ust-modules/USTTHUNDERMILLPCB03/README.md

# THUNDERMILL electrodes PCB

The PCB is part of [Electric field mill](https://github.com/UniversalScientificTechnologies/THUNDERMILL01).

<p float="left">
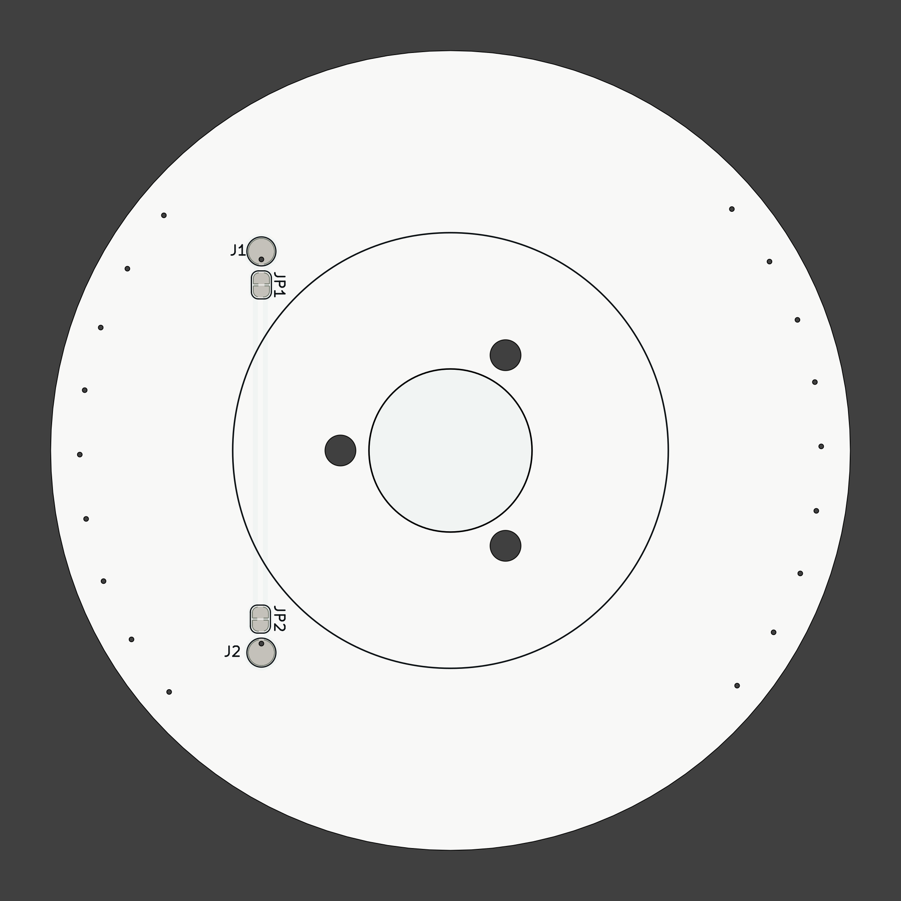
[picture p1: doc/gen/img/USTTHUNDERMILLPCB03-bottom.png]
  
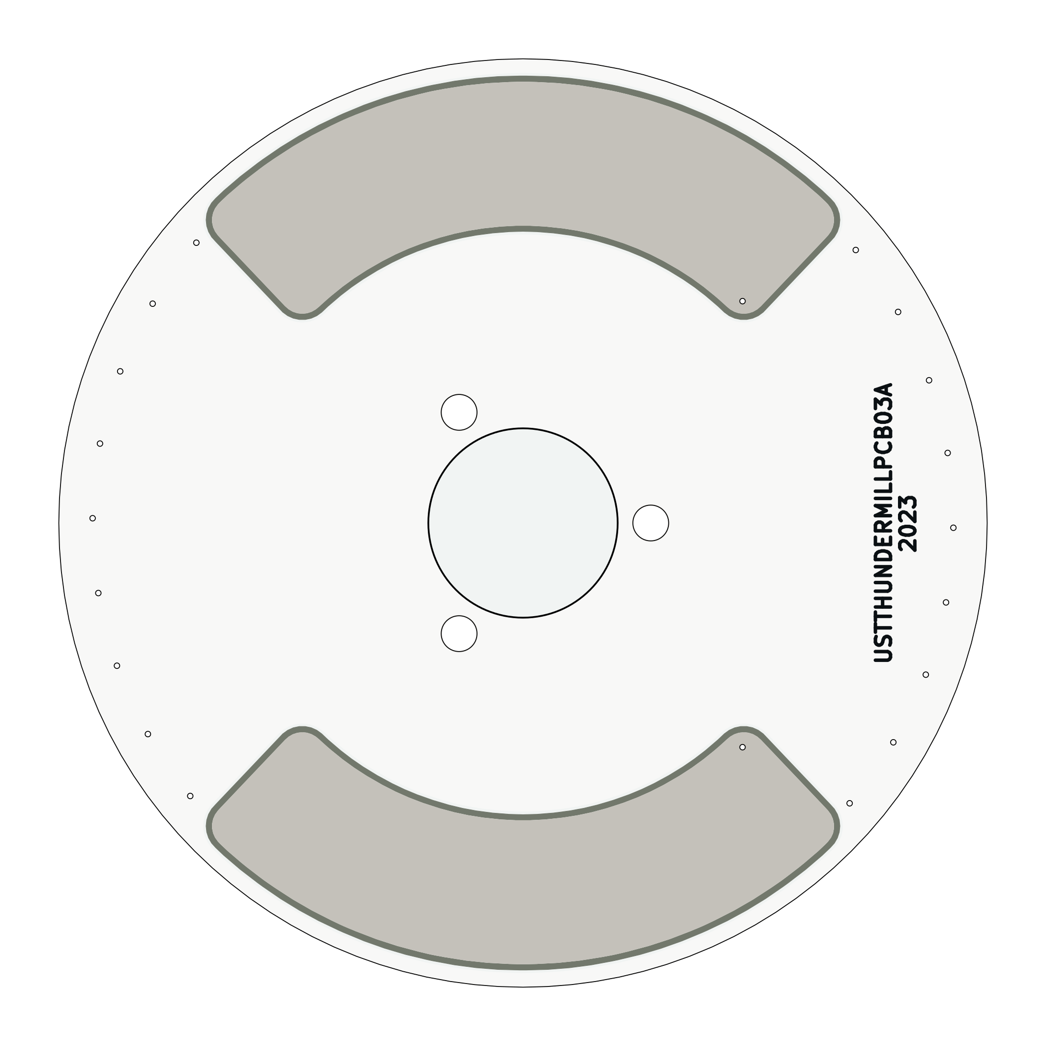
[picture p2: doc/gen/img/USTTHUNDERMILLPCB03-top.png]
   
</p>
