ust-modules/USTTHUNDERMILLPCB03/doc/gen/README.md

# PCB

Board size: 80.0x80.0 mm (3.15x3.15 inches)

- This is the size of the rectangle that contains the board
- Thickness: 1.6 mm (63 mils)
- Material: FR4
- Finish: Immersion gold
- Layers: 2
- Copper thickness: 35 µm

Solder mask: TOP / BOTTOM

- Color: White

Silk screen: TOP / BOTTOM

- Color: Black

Special features:

- Castellated pads
- Edge plating

Stackup:

| Name | Type | Color | Thickness | Material | Epsilon_r | Loss tangent |
|---|---|---|---|---|---|---|
| F.SilkS | Top Silk Screen | Black | | | | |
| F.Paste | Top Solder Paste | | | | | |
| F.Mask | Top Solder Mask | White | 10 | | | |
| F.Cu | copper | | 35 | | | |
| dielectric 1 | core | FR4 natural | 1510 | FR4 | 4.5 | 0.020 |
| B.Cu | copper | | 35 | | | |
| B.Mask | Bottom Solder Mask | White | 10 | | | |
| B.Paste | Bottom Solder Paste  | | | | | |
| B.SilkS | Bottom Silk Screen | Black | | | | |

# Important sizes

Clearance: 0.2 mm (8 mils)

Track width: 0.5 mm (20 mils)

- By design rules: 0.2 mm (8 mils)

Drill: 0.5 mm (20 mils)

- Vias: 0.5 mm (20 mils) [Design: 0.4 mm (16 mils)]
- Pads: 3.1 mm (122 mils)
- The above values are real drill sizes, they add 0.1 mm (4 mils) to plated holes (PTH)

Via: 0.8/0.4 mm (31/16 mils)

- By design rules: 0.4/0.3 mm (16/12 mils)
- Micro via: yes [0.2/0.1 mm (8/4 mils)]
- Buried/blind via: yes
- Total: 20 (thru: 20 buried/blind: 0 micro: 0)

Outer Annular Ring: 0.15 mm (6 mils)

- By design rules: N/A mm (N/A mils)

Eurocircuits class: 4B
- Using min drill 0.5 mm for an OAR of 0.15 mm

# General stats

Components count: (SMD/THT)

- Top: 0/3 (THT)
- Bottom: 0/0 (NONE)

Defined tracks:

- 0.2 mm (8 mils)
- 0.25 mm (10 mils)
- 0.3 mm (12 mils)
- 0.5 mm (20 mils)

Used tracks:

- 0.5 mm (20 mils) (6) defined: yes

Defined vias:

Used vias:

- 0.8/0.4 mm (31/16 mils) (Count: 20, Aspect: 2.0 A) defined: no

Holes (excluding vias):

- 3.0 mm (118 mils) (3)

Oval holes:

Drill tools (including vias and computing adjusts and rounding):

- 0.5 mm (20 mils) (20)
- 3.1 mm (122 mils) (3)
