ust-modules/USTTHUNDERMILLPCB03/doc/img/USTTHUNDERMILLPCB01A_bot.png

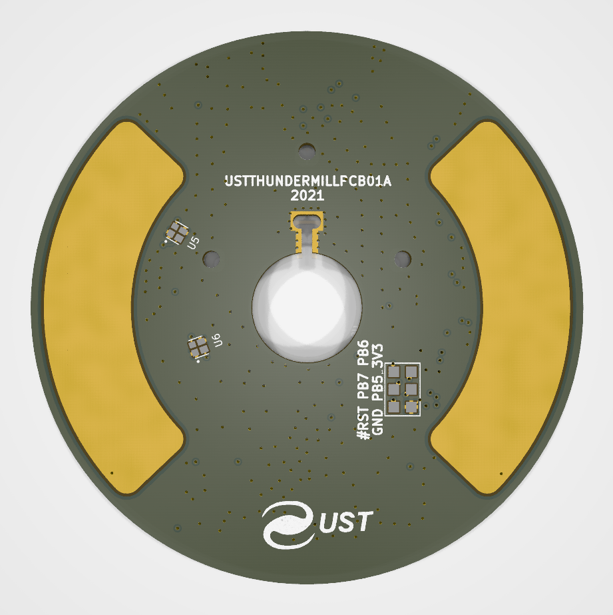
doc/img/USTTHUNDERMILLPCB01A_bot.png
