ust-modules/USTTHUNDERMILLPCB03/doc/img/USTTHUNDERMILLPCB01A_top.png

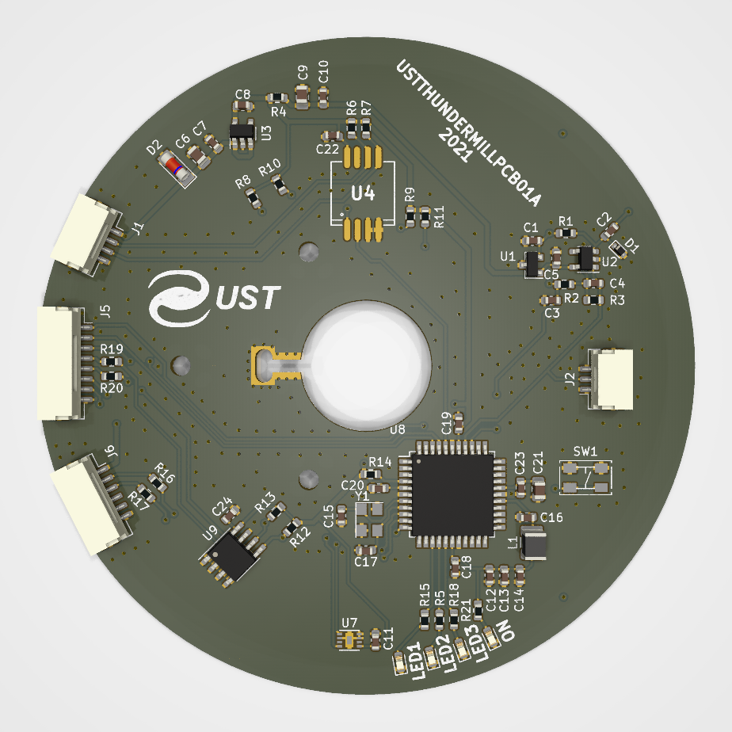
doc/img/USTTHUNDERMILLPCB01A_top.png
