ust-modules/USTTHUNDERMILLPCB03/CAD/stl/programming_holder.stl

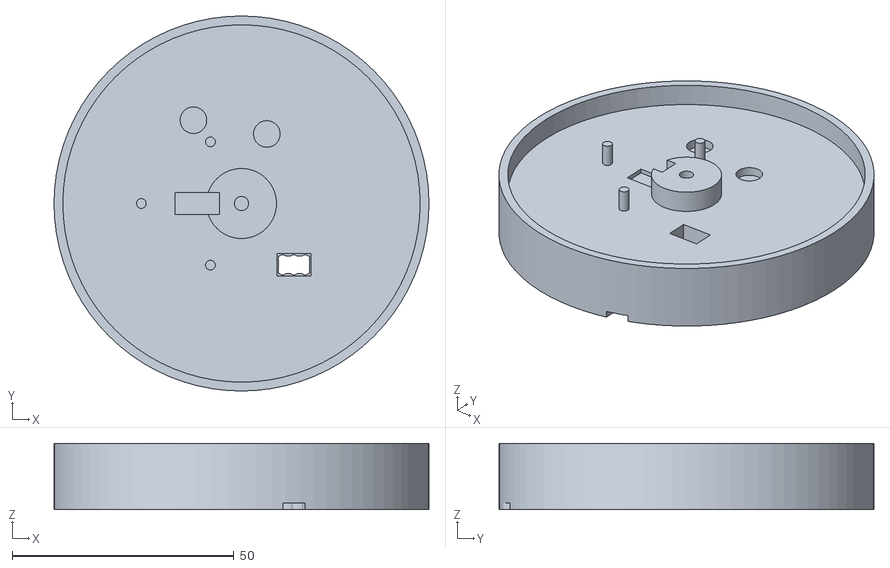
[picture p5: CAD file, 2021-08-31]
CAD/stl/programming_holder.stl
84.6 x 84.6 x 15.0
