ust-modules/USTTHUNDERMILLPCB03/doc/3d/USTTHUNDERMILLPCB03.stl

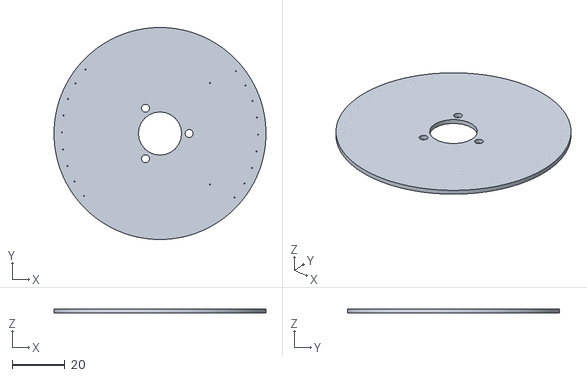
[picture p6: CAD file, 2025-04-03]
doc/3d/USTTHUNDERMILLPCB03.stl
80.0 x 80.0 x 1.66
