ust-modules/USTTHUNDERMILLPCB03/doc/gen/dxf/USTTHUNDERMILLPCB03-F_Fab.dxf

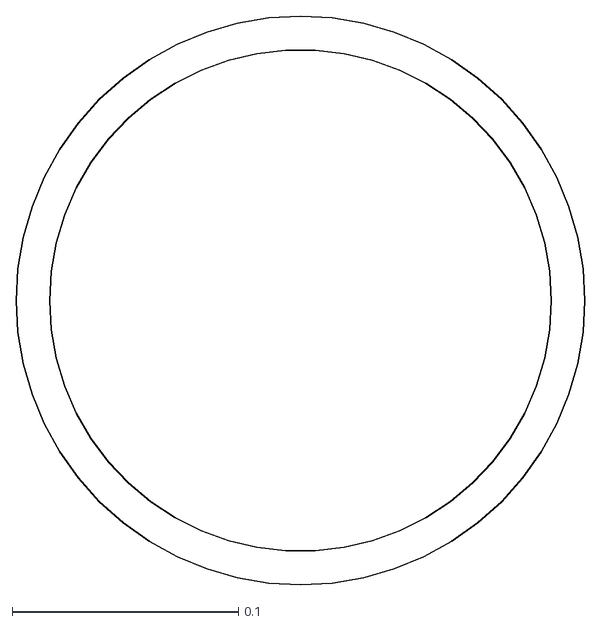
[picture p7: CAD file, 2025-04-03]
doc/gen/dxf/USTTHUNDERMILLPCB03-F_Fab.dxf
0.251 x 0.251
