ust-modules/USTTHUNDERMILLPCB03/doc/gen/USTTHUNDERMILLPCB03.step

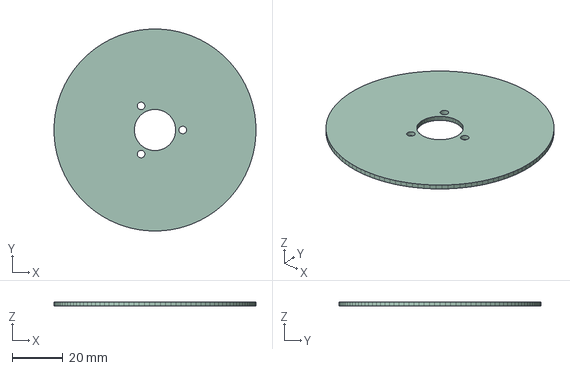
[picture p8: CAD file, 2025-04-03]
doc/gen/USTTHUNDERMILLPCB03.step
80.0 x 80.0 x 1.58 mm
