ust-modules/USTTHUNDERMILLPCB03/doc/gen/dxf/USTTHUNDERMILLPCB03-Edge_Cuts.dxf

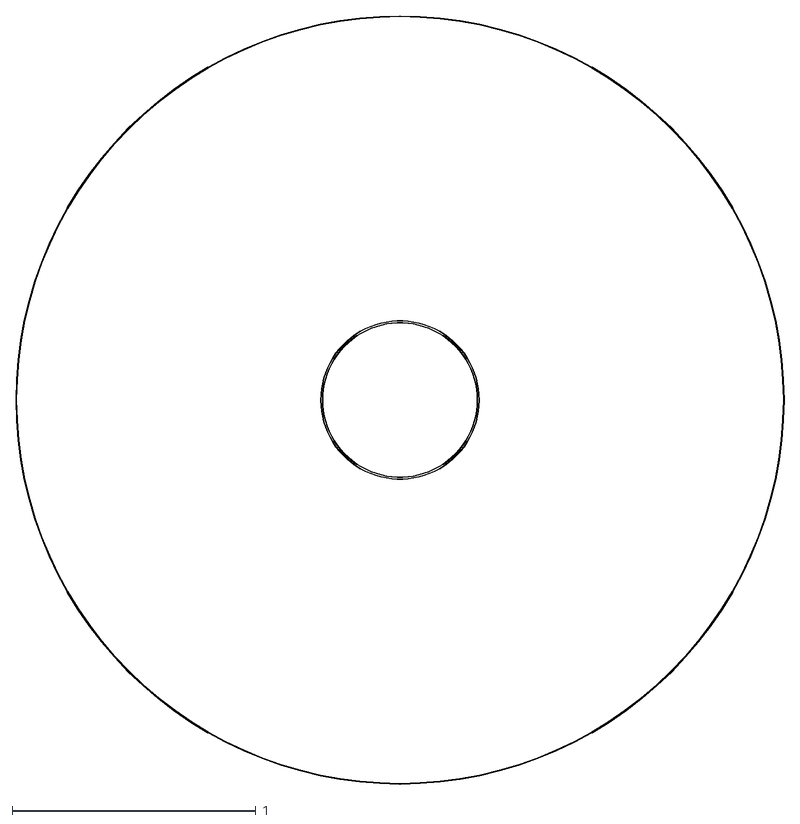
[picture p9: CAD file, 2025-04-03]
doc/gen/dxf/USTTHUNDERMILLPCB03-Edge_Cuts.dxf
3.15 x 3.15
