ust-modules/USTTHUNDERMILLPCB03/doc/gen/dxf/USTTHUNDERMILLPCB03-B_Fab.dxf

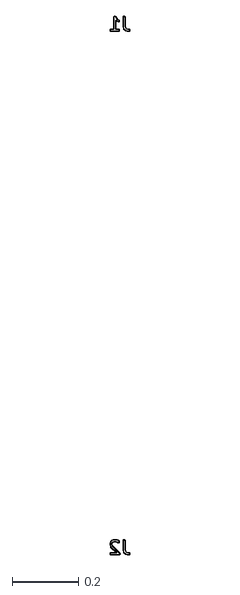
[picture p10: CAD file, 2025-04-03]
doc/gen/dxf/USTTHUNDERMILLPCB03-B_Fab.dxf
0.0602 x 1.62
