ust-modules/USTTHUNDERMILLPCB03/doc/gen/dxf/USTTHUNDERMILLPCB03-B_Cu.dxf

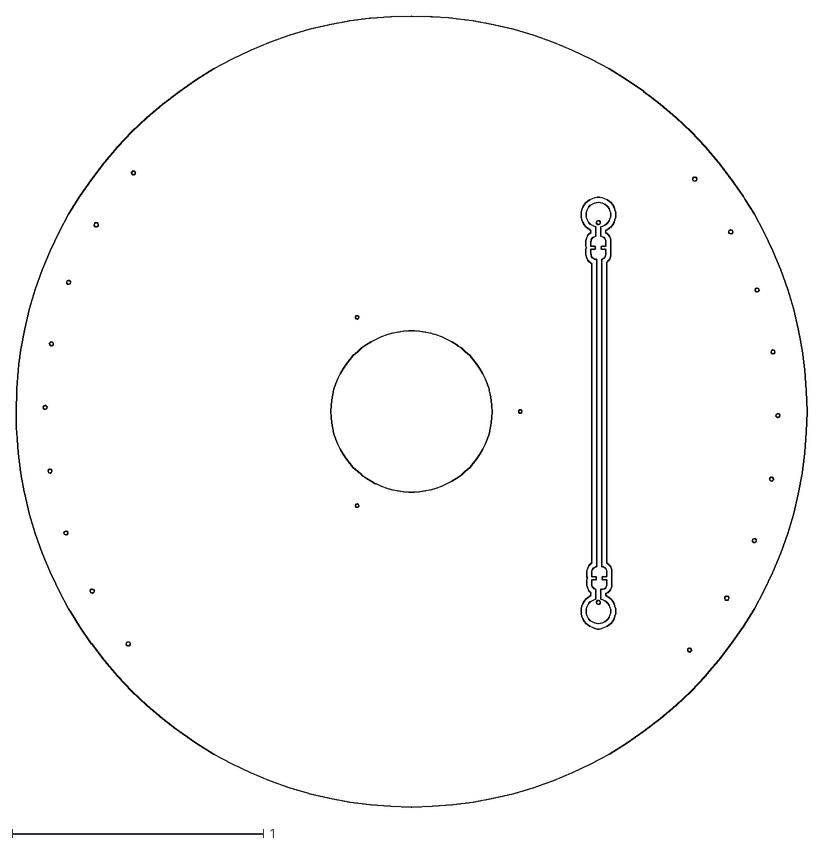
[picture p12: CAD file, 2025-04-03]
doc/gen/dxf/USTTHUNDERMILLPCB03-B_Cu.dxf
3.15 x 3.15
