ust-modules/USTTHUNDERMILLPCB03/doc/gen/dxf/USTTHUNDERMILLPCB03-User_Comments.dxf

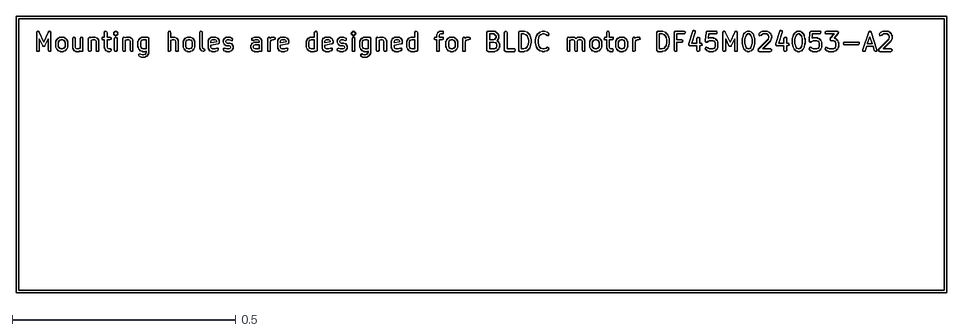
[picture p13: CAD file, 2025-04-03]
doc/gen/dxf/USTTHUNDERMILLPCB03-User_Comments.dxf
2.08 x 0.62
