ust-modules/USTTHUNDERMILLPCB03/doc/gen/dxf/USTTHUNDERMILLPCB03-B_Courtyard.dxf

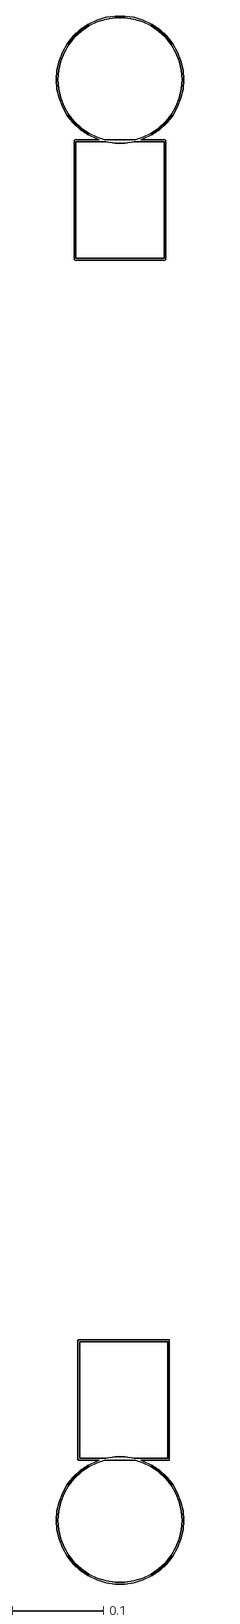
[picture p14: CAD file, 2025-04-03]
doc/gen/dxf/USTTHUNDERMILLPCB03-B_Courtyard.dxf
0.14 x 1.72
