ust-modules/USTTHUNDERMILLPCB03/(list of files, cad)

Other CAD files:
doc/gen/dxf/USTTHUNDERMILLPCB03-User_Drawings.dxf
doc/gen/dxf/USTTHUNDERMILLPCB03-B_Adhesive.dxf
doc/gen/dxf/USTTHUNDERMILLPCB03-F_Adhesive.dxf
doc/gen/dxf/USTTHUNDERMILLPCB03-F_Courtyard.dxf
doc/gen/dxf/USTTHUNDERMILLPCB03-Margin.dxf
doc/gen/dxf/USTTHUNDERMILLPCB03-B_Mask.dxf
doc/gen/dxf/USTTHUNDERMILLPCB03-B_Paste.dxf
doc/gen/dxf/USTTHUNDERMILLPCB03-B_Silkscreen.dxf
doc/gen/dxf/USTTHUNDERMILLPCB03-F_Mask.dxf
doc/gen/dxf/USTTHUNDERMILLPCB03-F_Paste.dxf
doc/gen/dxf/USTTHUNDERMILLPCB03-F_Silkscreen.dxf
