ust-modules/USTTHUNDERMILLPCB03/doc/gen/USTTHUNDERMILLPCB03-schematic.pdf

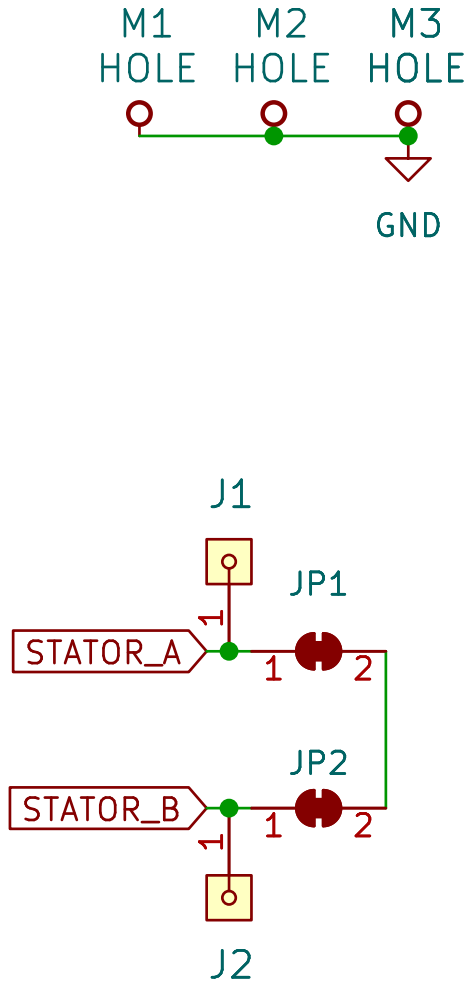
[picture p15: page 1]
