ust-modules/USTTHUNDERMILLPCB03/hw/cam_profi/docs/USTTHUNDERMILLPCB03A-B_Fab+Edge_Cuts.pdf

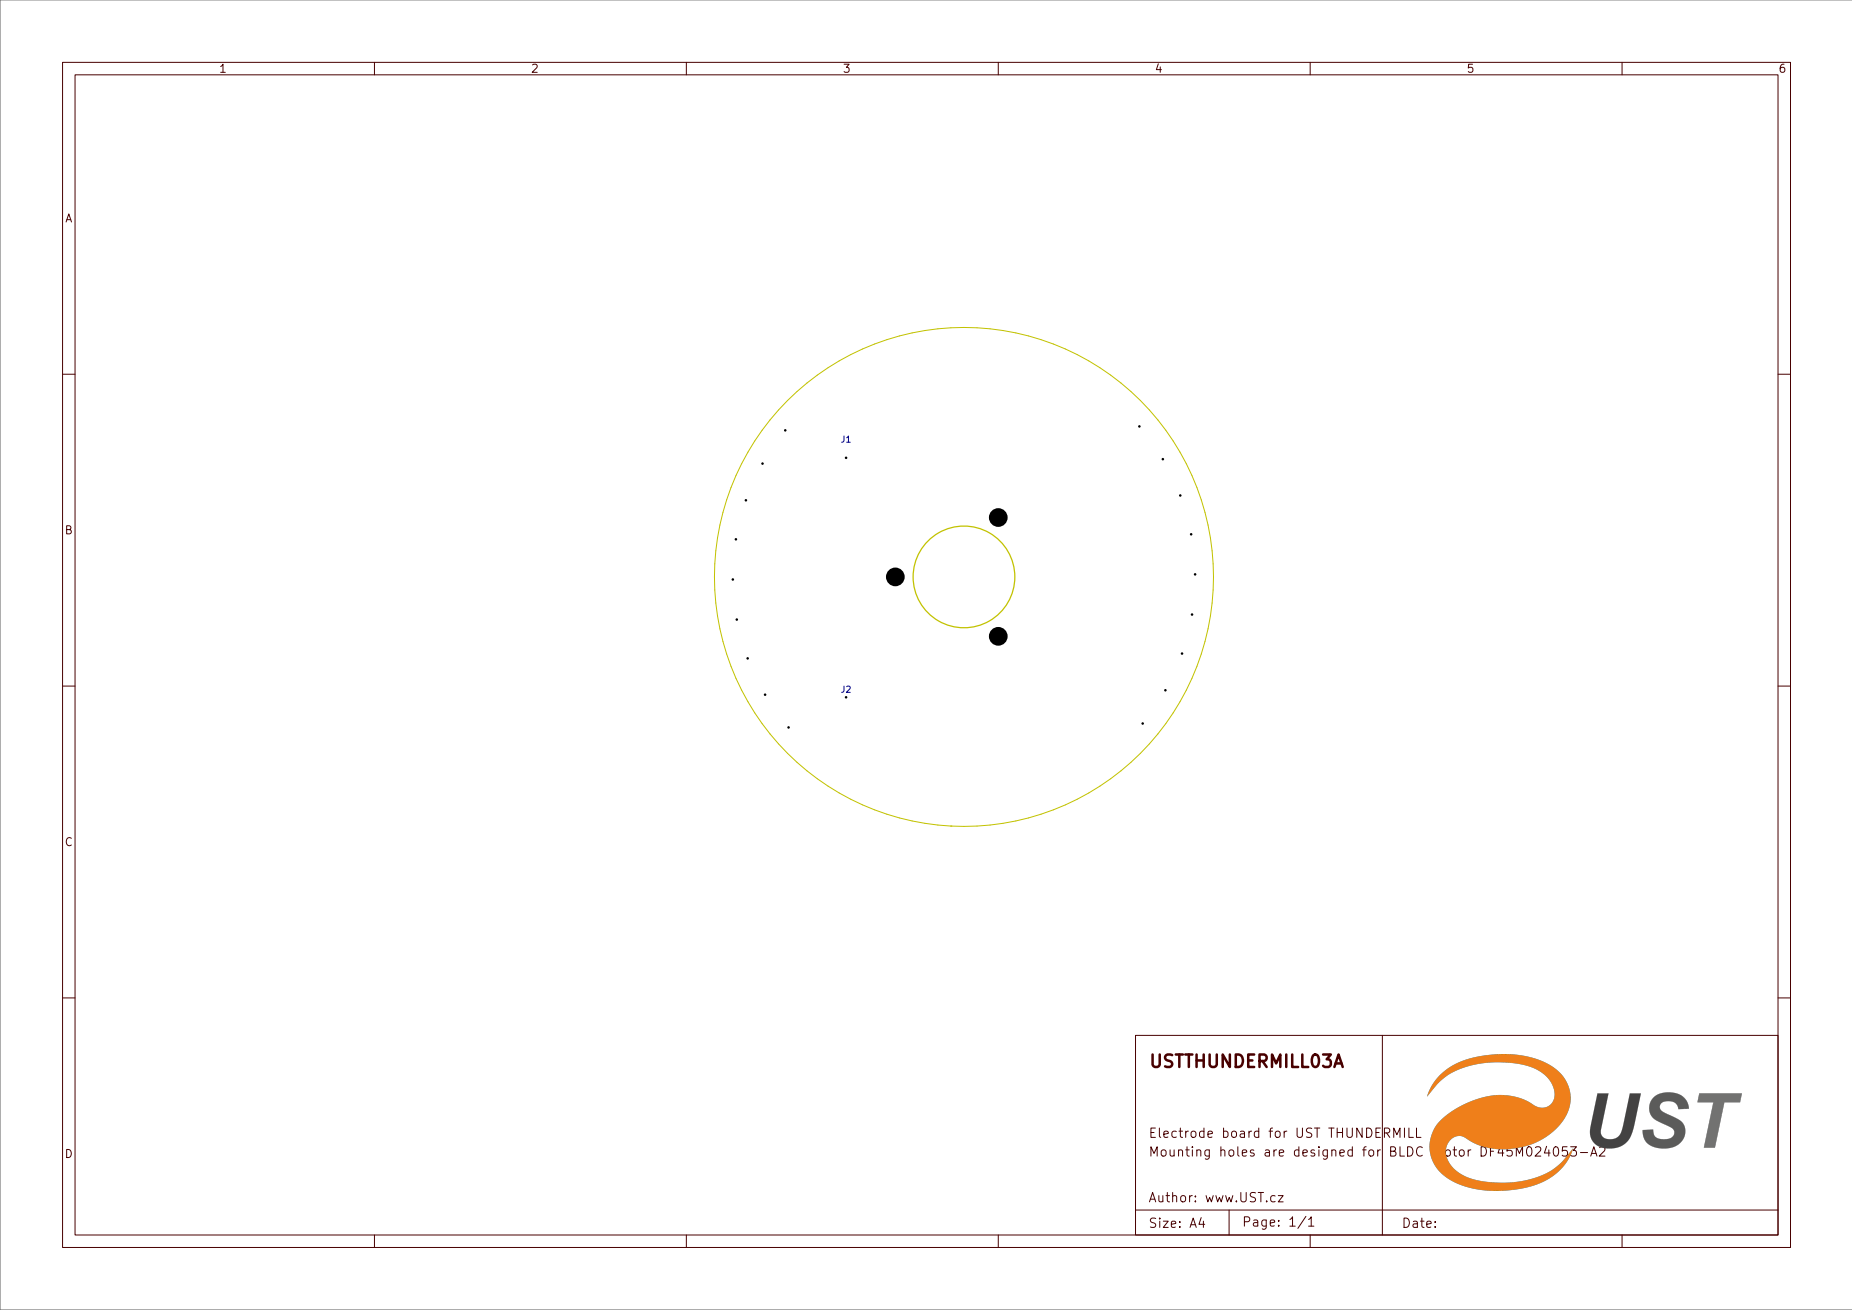
[picture p16: page 1]
