ust-modules/USTTHUNDERMILLPCB03/hw/cam_profi/docs/USTTHUNDERMILLPCB03A-F_Fab+Edge_Cuts.pdf

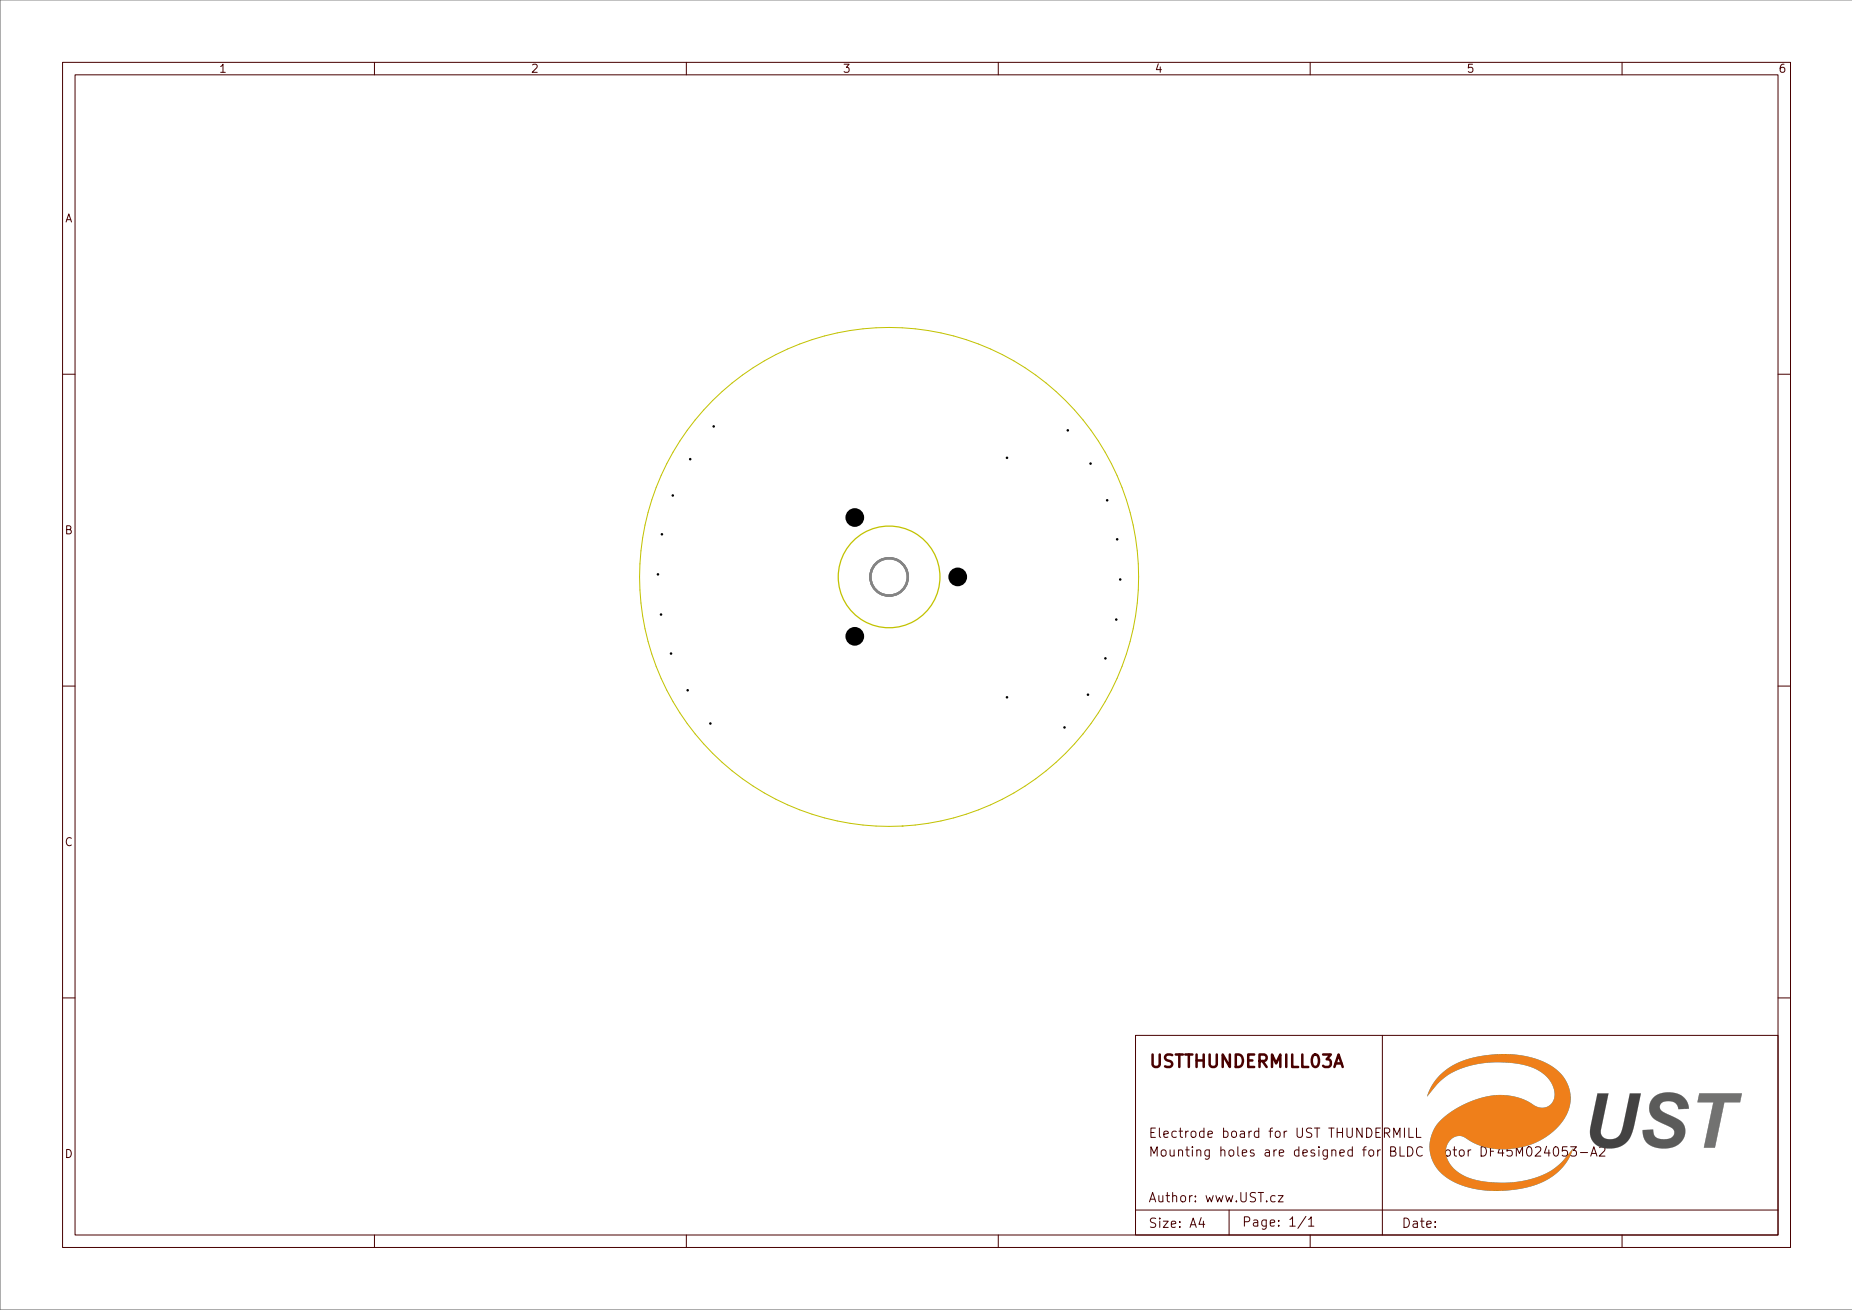
[picture p17: page 1]
