ust-modules/USTTHUNDERMILLPCB03/(commit log)

2021-07-23 Edit schema
    [USTTHUNDERMILLPCB01A.kicad_pcb, USTTHUNDERMILLPCB01A.kicad_sch, tachometer.kicad_sch]
2021-08-18 Edit PCB
    [USTTHUNDERMILLPCB01A.kicad_pcb]
2021-08-18 Import Openscad exports
    [USTTHUNDERMILLPCB01A.kicad_pcb]
2021-08-18 uprava layoutu
    [USTTHUNDERMILLPCB01A.kicad_pcb]
2021-08-20 uprava layoutu, aktualizace elektrod
    [USTTHUNDERMILLPCB01A.kicad_pcb, USTTHUNDERMILLPCB01A.kicad_sch, tachometer.kicad_sch]
2021-08-21 Edit vylití CU
    [USTTHUNDERMILLPCB01A.kicad_pcb]
2021-08-21 uprava pcb
    [USTTHUNDERMILLPCB01A.kicad_pcb]
2021-08-22 edit pcb
    [USTTHUNDERMILLPCB01A.kicad_pcb]
2021-08-23 Edit shema and PCB
    [CPU.kicad_sch, USTTHUNDERMILLPCB01A.kicad_pcb, USTTHUNDERMILLPCB01A.kicad_sch, tachometer.kicad_sch]
2021-08-23 uprava PCB - zmena mlynku - oddeleni propojovaci cesticky.
    [USTTHUNDERMILLPCB01A.kicad_pcb]
2021-08-23 otoceni cesticky
    [USTTHUNDERMILLPCB01A.kicad_pcb]
2021-08-24 Pridani keep-out okolo elektrod
    [USTTHUNDERMILLPCB01A.kicad_pcb]
2021-08-24 zmena okraju
    [USTTHUNDERMILLPCB01A.kicad_pcb]
2021-08-24 Clean layout of some tracks by using free-angle rounting.
    [USTTHUNDERMILLPCB01A.kicad_pcb]
2021-08-24 Logo moved to the rotor window.
    [USTTHUNDERMILLPCB01A.kicad_pcb]
2021-08-24 Move connectors.
    [USTTHUNDERMILLPCB01A.kicad_pcb]
2021-08-24 Silkscreen cleanup - DRC errors elimination.
    [CPU.kicad_sch, USTTHUNDERMILLPCB01A.kicad_pcb, USTTHUNDERMILLPCB01A.kicad_sch, tachometer.kicad_sch]
2021-08-24 Eliminate some DRC errors.
    [USTTHUNDERMILLPCB01A.kicad_pcb]
2021-08-24 Cleanup silkscreen graphics. Turn on labels.
    [USTTHUNDERMILLPCB01A.kicad_pcb]
2021-08-25 Change colors in PCB board stackup.
    [USTTHUNDERMILLPCB01A.kicad_pcb]
2021-08-27 Edit BOM
    [USTTHUNDERMILLPCB01A.csv, USTTHUNDERMILLPCB01A.kicad_sch]
2021-08-27 add CAD programming tool
    [programming_holder.scad, programming_holder.stl]
2021-09-01 nefunkcni ADC
2021-09-05 RPM sensor output was added to mavlink packet
2021-12-24 Add UST title block and assets submodule.
    [CPU.kicad_sch, USTTHUNDERMILLPCB01A.kicad_sch, tachometer.kicad_sch]
2022-04-17 clean repo, restructualize git repository, add actions, ..
    [CPU.kicad_sch, USTTHUNDERMILLPCB01.csv, USTTHUNDERMILLPCB01.kicad_pcb, USTTHUNDERMILLPCB01.kicad_sch, USTTHUNDERMILLPCB01A.kicad_pcb, tachometer.kicad_sch]
2022-04-17 Update actions products
    [USTTHUNDERMILLPCB01-B_Adhesive.dxf, USTTHUNDERMILLPCB01-B_Courtyard.dxf, USTTHUNDERMILLPCB01-B_Cu.dxf, USTTHUNDERMILLPCB01-B_Fab.dxf, USTTHUNDERMILLPCB01-B_Mask.dxf, USTTHUNDERMILLPCB01-B_Paste.dxf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]
2022-04-17 resave in 6.0.4
    [USTTHUNDERMILLPCB01.kicad_pcb, USTTHUNDERMILLPCB01.kicad_sch]
2023-06-08 solve #3 in schematics, not in layout
    [CPU.kicad_sch, USTTHUNDERMILLPCB01.kicad_sch]
2023-06-09 Schema: #7 add schmidt, #6, #8 dvojice UART konetkoru + i2c, #3 pridan kondenzator a propojeni na RST
    [CPU.kicad_sch, USTTHUNDERMILLPCB01.kicad_sch, tachometer.kicad_sch]
2023-06-13 updates of schematics and layout: solve: #6, #3, #8, #10
    [CPU.kicad_sch, USTTHUNDERMILLPCB01.kicad_pcb, USTTHUNDERMILLPCB01.kicad_sch, tachometer.kicad_sch]
2023-06-13 uprava silkscreenu, pridani popisku konektoru
    [USTTHUNDERMILLPCB01.kicad_pcb]
2023-06-13 Update layout, add 3rd position sensor
    [CPU.kicad_sch, USTTHUNDERMILLPCB01.kicad_pcb, USTTHUNDERMILLPCB01.kicad_sch, tachometer.kicad_sch]
2023-06-13 solve DRC, check ERC
    [CPU.kicad_sch, USTTHUNDERMILLPCB01.kicad_pcb, USTTHUNDERMILLPCB01.kicad_sch]
2023-06-15 add logo
    [USTTHUNDERMILLPCB01.kicad_pcb]
2023-06-19 Add basic dimensions.
    [USTTHUNDERMILLPCB01.kicad_pcb]
2023-06-28 analogue power
    [CPU.kicad_sch, USTTHUNDERMILLPCB01.kicad_pcb, USTTHUNDERMILLPCB01.kicad_sch, tachometer.kicad_sch]
2023-06-28 assets to kicad 7
2023-06-28 Update layout
    [USTTHUNDERMILLPCB01.kicad_pcb, USTTHUNDERMILLPCB01.kicad_sch, tachometer.kicad_sch]
2023-06-30 pridani testopintu pro pripojeni externi elektrody
    [USTTHUNDERMILLPCB01.kicad_pcb, USTTHUNDERMILLPCB01.kicad_sch]
2023-07-01 clean repository after fork, Update to stator variant
    [CPU.kicad_sch, USTTHUNDERMILLPCB01.csv, USTTHUNDERMILLPCB01.kicad_pcb, USTTHUNDERMILLPCB01.kicad_sch, USTTHUNDERMILLPCB03.kicad_pcb, USTTHUNDERMILLPCB03.kicad_sch, tachometer.kicad_sch]
2025-04-03 3d files
    [USTTHUNDERMILLPCB03.stl]
